Normansrule/pixelstorm-gpu/docs/img/fpga-vga-1.png

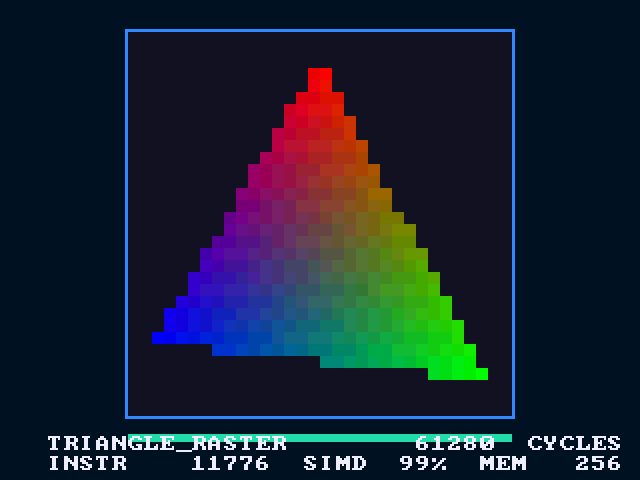
docs/img/fpga-vga-1.png
