Normansrule/pixelstorm-gpu/docs/img/fpga-vga-3.png

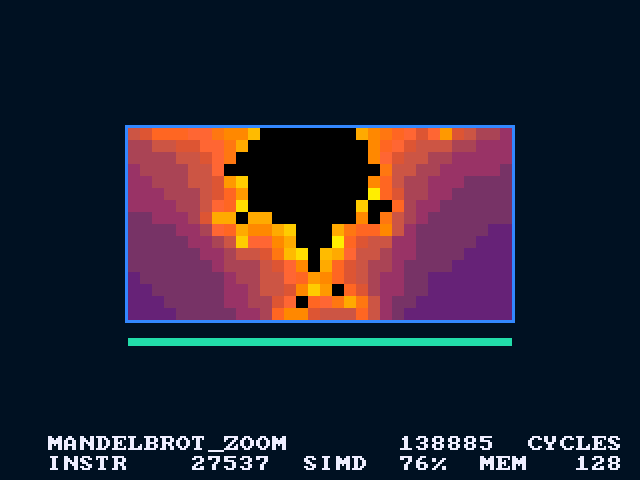
docs/img/fpga-vga-3.png
