Normansrule/pixelstorm-gpu/fpga/boards/nexys_a7/nexys_a7.xdc

## Pixelstorm on the Digilent Nexys A7-100T. Pin names follow Digilent's
## Nexys-A7-100T-Master.xdc (github.com/Digilent/digilent-xdc); check against it
## if your board revision differs. All used pins are 3.3 V (LVCMOS33).
set_property -dict {PACKAGE_PIN E3  IOSTANDARD LVCMOS33} [get_ports CLK100MHZ]
create_clock -period 10.000 -name sys_clk [get_ports CLK100MHZ]
set_property -dict {PACKAGE_PIN C12 IOSTANDARD LVCMOS33} [get_ports CPU_RESETN]
set_property -dict {PACKAGE_PIN N17 IOSTANDARD LVCMOS33} [get_ports BTNC]
set_property -dict {PACKAGE_PIN J15 IOSTANDARD LVCMOS33} [get_ports {SW[0]}]
set_property -dict {PACKAGE_PIN L16 IOSTANDARD LVCMOS33} [get_ports {SW[1]}]
set_property -dict {PACKAGE_PIN M13 IOSTANDARD LVCMOS33} [get_ports {SW[2]}]
set_property -dict {PACKAGE_PIN R15 IOSTANDARD LVCMOS33} [get_ports {SW[3]}]
set_property -dict {PACKAGE_PIN R17 IOSTANDARD LVCMOS33} [get_ports {SW[4]}]
set_property -dict {PACKAGE_PIN T18 IOSTANDARD LVCMOS33} [get_ports {SW[5]}]
set_property -dict {PACKAGE_PIN U18 IOSTANDARD LVCMOS33} [get_ports {SW[6]}]
set_property -dict {PACKAGE_PIN R13 IOSTANDARD LVCMOS33} [get_ports {SW[7]}]
## SW8 and SW9 are in a 1.8 V bank on this board
set_property -dict {PACKAGE_PIN T8  IOSTANDARD LVCMOS18} [get_ports {SW[8]}]
set_property -dict {PACKAGE_PIN U8  IOSTANDARD LVCMOS18} [get_ports {SW[9]}]
set_property -dict {PACKAGE_PIN R16 IOSTANDARD LVCMOS33} [get_ports {SW[10]}]
set_property -dict {PACKAGE_PIN T13 IOSTANDARD LVCMOS33} [get_ports {SW[11]}]
set_property -dict {PACKAGE_PIN H6  IOSTANDARD LVCMOS33} [get_ports {SW[12]}]
set_property -dict {PACKAGE_PIN U12 IOSTANDARD LVCMOS33} [get_ports {SW[13]}]
set_property -dict {PACKAGE_PIN U11 IOSTANDARD LVCMOS33} [get_ports {SW[14]}]
set_property -dict {PACKAGE_PIN V10 IOSTANDARD LVCMOS33} [get_ports {SW[15]}]
set_property -dict {PACKAGE_PIN H17 IOSTANDARD LVCMOS33} [get_ports {LED[0]}]
set_property -dict {PACKAGE_PIN K15 IOSTANDARD LVCMOS33} [get_ports {LED[1]}]
set_property -dict {PACKAGE_PIN J13 IOSTANDARD LVCMOS33} [get_ports {LED[2]}]
set_property -dict {PACKAGE_PIN N14 IOSTANDARD LVCMOS33} [get_ports {LED[3]}]
set_property -dict {PACKAGE_PIN R18 IOSTANDARD LVCMOS33} [get_ports {LED[4]}]
set_property -dict {PACKAGE_PIN V17 IOSTANDARD LVCMOS33} [get_ports {LED[5]}]
set_property -dict {PACKAGE_PIN U17 IOSTANDARD LVCMOS33} [get_ports {LED[6]}]
set_property -dict {PACKAGE_PIN U16 IOSTANDARD LVCMOS33} [get_ports {LED[7]}]
set_property -dict {PACKAGE_PIN V16 IOSTANDARD LVCMOS33} [get_ports {LED[8]}]
set_property -dict {PACKAGE_PIN T15 IOSTANDARD LVCMOS33} [get_ports {LED[9]}]
set_property -dict {PACKAGE_PIN U14 IOSTANDARD LVCMOS33} [get_ports {LED[10]}]
set_property -dict {PACKAGE_PIN T16 IOSTANDARD LVCMOS33} [get_ports {LED[11]}]
set_property -dict {PACKAGE_PIN V15 IOSTANDARD LVCMOS33} [get_ports {LED[12]}]
set_property -dict {PACKAGE_PIN V14 IOSTANDARD LVCMOS33} [get_ports {LED[13]}]
set_property -dict {PACKAGE_PIN V12 IOSTANDARD LVCMOS33} [get_ports {LED[14]}]
set_property -dict {PACKAGE_PIN V11 IOSTANDARD LVCMOS33} [get_ports {LED[15]}]
set_property -dict {PACKAGE_PIN A3  IOSTANDARD LVCMOS33} [get_ports {VGA_R[0]}]
set_property -dict {PACKAGE_PIN B4  IOSTANDARD LVCMOS33} [get_ports {VGA_R[1]}]
set_property -dict {PACKAGE_PIN C5  IOSTANDARD LVCMOS33} [get_ports {VGA_R[2]}]
set_property -dict {PACKAGE_PIN A4  IOSTANDARD LVCMOS33} [get_ports {VGA_R[3]}]
set_property -dict {PACKAGE_PIN C6  IOSTANDARD LVCMOS33} [get_ports {VGA_G[0]}]
set_property -dict {PACKAGE_PIN A5  IOSTANDARD LVCMOS33} [get_ports {VGA_G[1]}]
set_property -dict {PACKAGE_PIN B6  IOSTANDARD LVCMOS33} [get_ports {VGA_G[2]}]
set_property -dict {PACKAGE_PIN A6  IOSTANDARD LVCMOS33} [get_ports {VGA_G[3]}]
set_property -dict {PACKAGE_PIN B7  IOSTANDARD LVCMOS33} [get_ports {VGA_B[0]}]
set_property -dict {PACKAGE_PIN C7  IOSTANDARD LVCMOS33} [get_ports {VGA_B[1]}]
set_property -dict {PACKAGE_PIN D7  IOSTANDARD LVCMOS33} [get_ports {VGA_B[2]}]
set_property -dict {PACKAGE_PIN D8  IOSTANDARD LVCMOS33} [get_ports {VGA_B[3]}]
set_property -dict {PACKAGE_PIN B11 IOSTANDARD LVCMOS33} [get_ports VGA_HS]
set_property -dict {PACKAGE_PIN B12 IOSTANDARD LVCMOS33} [get_ports VGA_VS]
set_property -dict {PACKAGE_PIN T10 IOSTANDARD LVCMOS33} [get_ports CA]
set_property -dict {PACKAGE_PIN R10 IOSTANDARD LVCMOS33} [get_ports CB]
set_property -dict {PACKAGE_PIN K16 IOSTANDARD LVCMOS33} [get_ports CC]
set_property -dict {PACKAGE_PIN K13 IOSTANDARD LVCMOS33} [get_ports CD]
set_property -dict {PACKAGE_PIN P15 IOSTANDARD LVCMOS33} [get_ports CE]
set_property -dict {PACKAGE_PIN T11 IOSTANDARD LVCMOS33} [get_ports CF]
set_property -dict {PACKAGE_PIN L18 IOSTANDARD LVCMOS33} [get_ports CG]
set_property -dict {PACKAGE_PIN H15 IOSTANDARD LVCMOS33} [get_ports DP]
set_property -dict {PACKAGE_PIN J17 IOSTANDARD LVCMOS33} [get_ports {AN[0]}]
set_property -dict {PACKAGE_PIN J18 IOSTANDARD LVCMOS33} [get_ports {AN[1]}]
set_property -dict {PACKAGE_PIN T9  IOSTANDARD LVCMOS33} [get_ports {AN[2]}]
set_property -dict {PACKAGE_PIN J14 IOSTANDARD LVCMOS33} [get_ports {AN[3]}]
set_property -dict {PACKAGE_PIN P14 IOSTANDARD LVCMOS33} [get_ports {AN[4]}]
set_property -dict {PACKAGE_PIN T14 IOSTANDARD LVCMOS33} [get_ports {AN[5]}]
set_property -dict {PACKAGE_PIN K2  IOSTANDARD LVCMOS33} [get_ports {AN[6]}]
set_property -dict {PACKAGE_PIN U13 IOSTANDARD LVCMOS33} [get_ports {AN[7]}]
set_property -dict {PACKAGE_PIN D4  IOSTANDARD LVCMOS33} [get_ports UART_RXD_OUT]
set_property -dict {PACKAGE_PIN C4  IOSTANDARD LVCMOS33} [get_ports UART_TXD_IN]
## the GPU clock is a gated copy of the 25 MHz pixel clock
set_property CONFIG_VOLTAGE 3.3 [current_design]
set_property CFGBVS VCCO [current_design]
