Normansrule/pixelstorm-gpu/(commit log)

2026-09-27 v1.1.0: SkyWater 130 nm silicon: synthesis, placed GDS, KLayout renders, silicon page, chapter 14
2026-09-28 v1.2.0: 3D guided tour (fetch, registers, DRAM vs cache, rasterization), single-sourced silicon numbers, CI fix
    [chapter.py]
2026-10-02 v1.5.0: Tang Nano 20K with HDMI, TMDS encoder, on-screen status, buying guide, datasheet for 3 boards
2026-10-02 v1.6.0: Basys 3 reference board, kernel upload over USB, quick start, 3-shape board simulation
2026-10-02 v1.7.0: hardware performance counters, animation mode, live switch arguments
